robdobsn/Marty-Swing/Blog/images/Marty's Head Adjustments.jpg

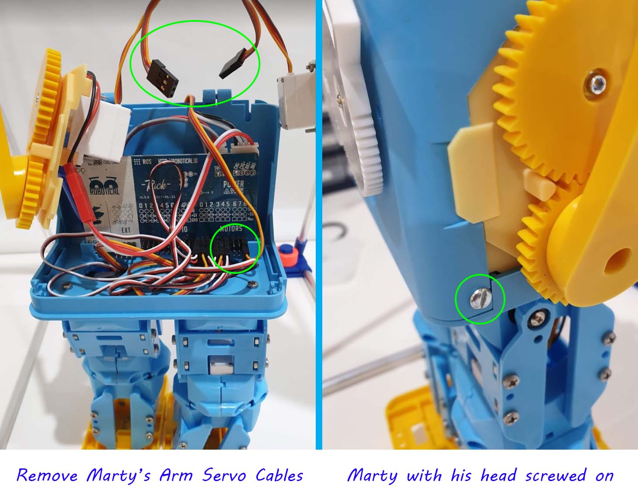
Blog/images/Marty's Head Adjustments.jpg
