robdobsn/Marty-Swing/Blog/images/Marty Attempting to Sit and Bend Knees.jpg

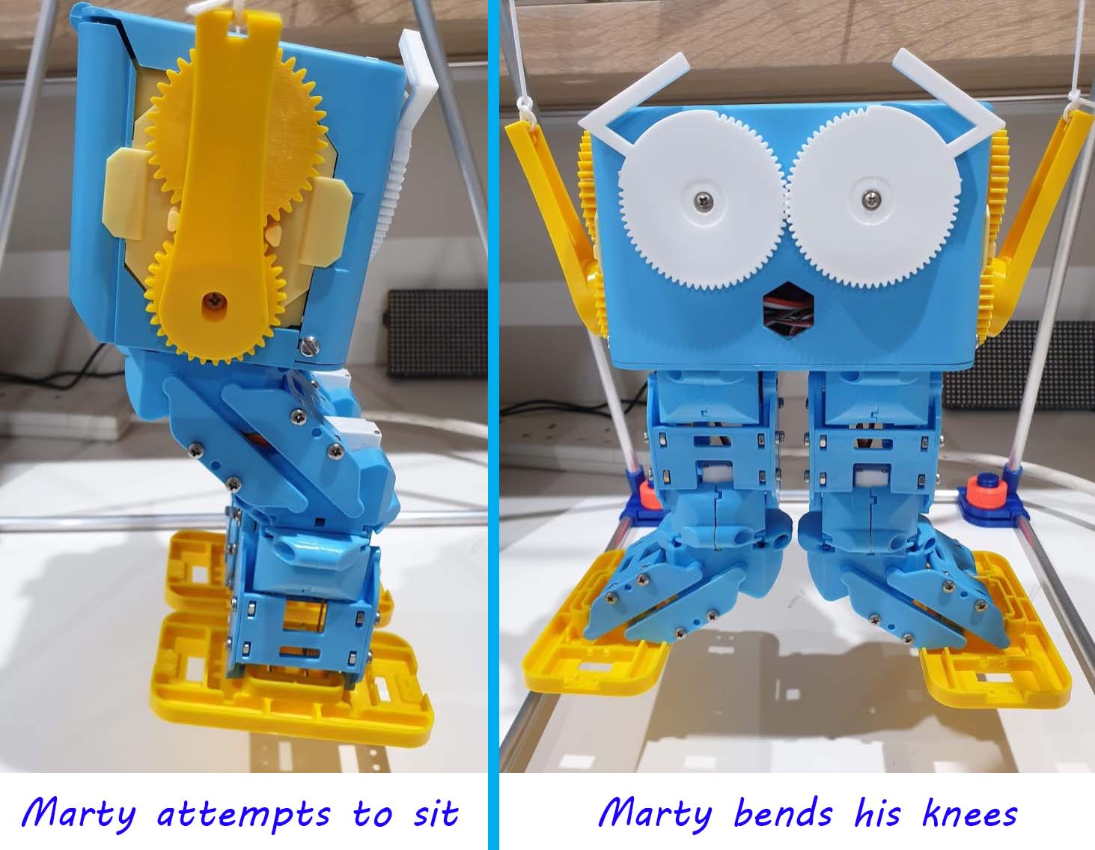
Blog/images/Marty Attempting to Sit and Bend Knees.jpg
