robdobsn/Marty-Swing/README.md

Marty Learns to Ride a Playground Swing
=======================================

Code and more to support the blog post "Marty Learns to Ride a Swing"
More information here https://robdobson.com/2019/07/marty-learns-to-ride-a-swing/
