robdobsn/Marty-Swing/Blog/images/Disconnecting Marty's Arm Servo Cables.PNG

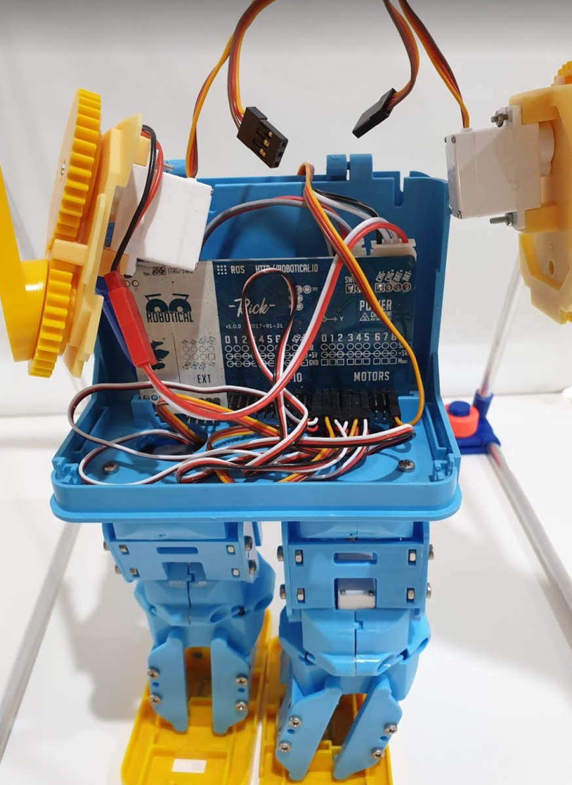
Blog/images/Disconnecting Marty's Arm Servo Cables.PNG
