robdobsn/Marty-Swing/Blog/images/FreeSwingData.png

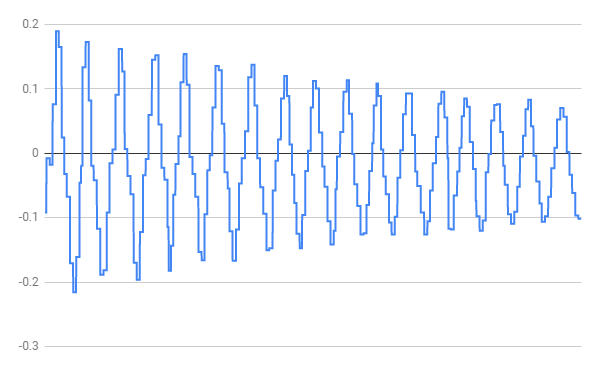
Blog/images/FreeSwingData.png
