robdobsn/Marty-Swing/Blog/images/Marty Attempting to Sit.PNG

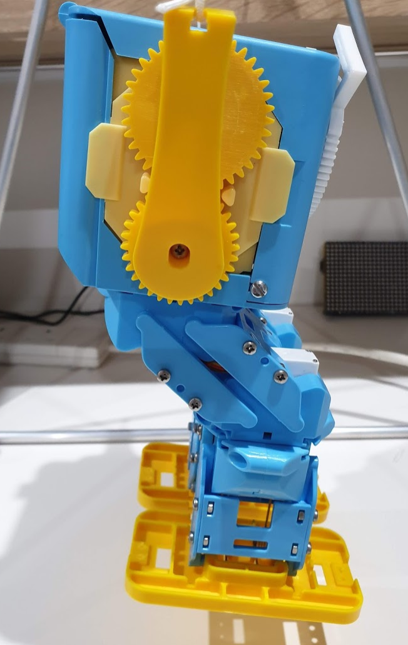
Blog/images/Marty Attempting to Sit.PNG
