robdobsn/Marty-Swing/Blog/images/Marty Bending his Knees.PNG

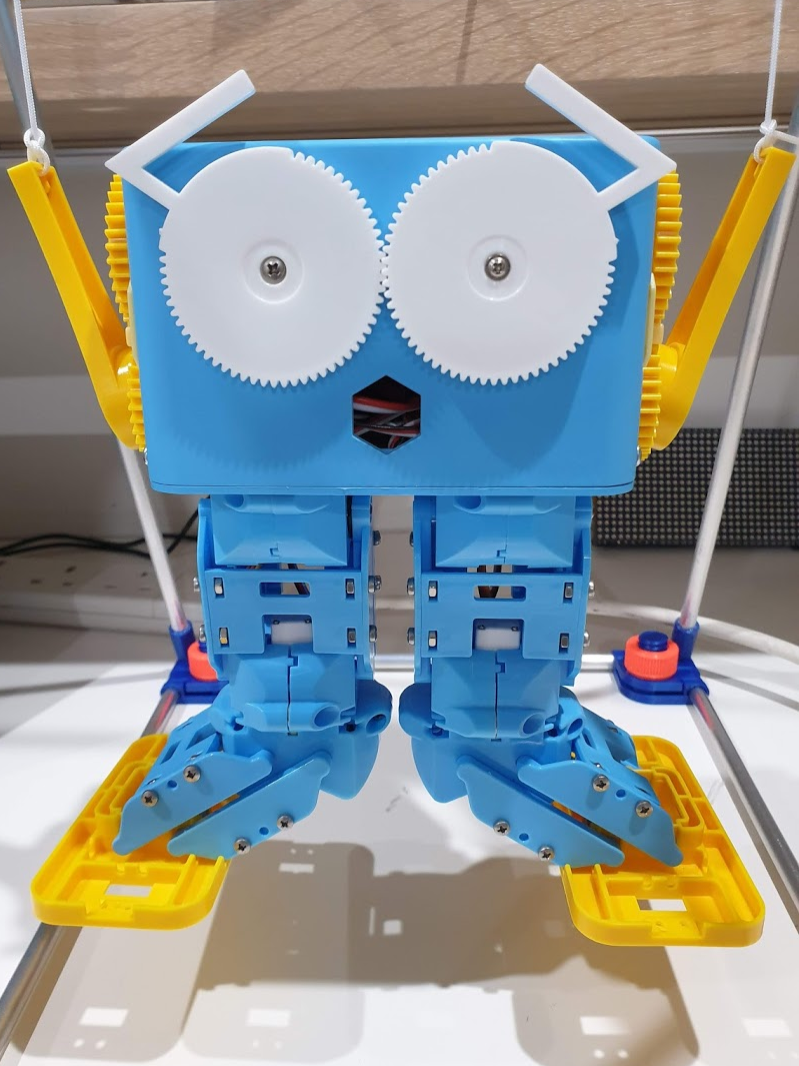
Blog/images/Marty Bending his Knees.PNG
