robdobsn/Marty-Swing/Blog/images/Marty on his Swing.jpg

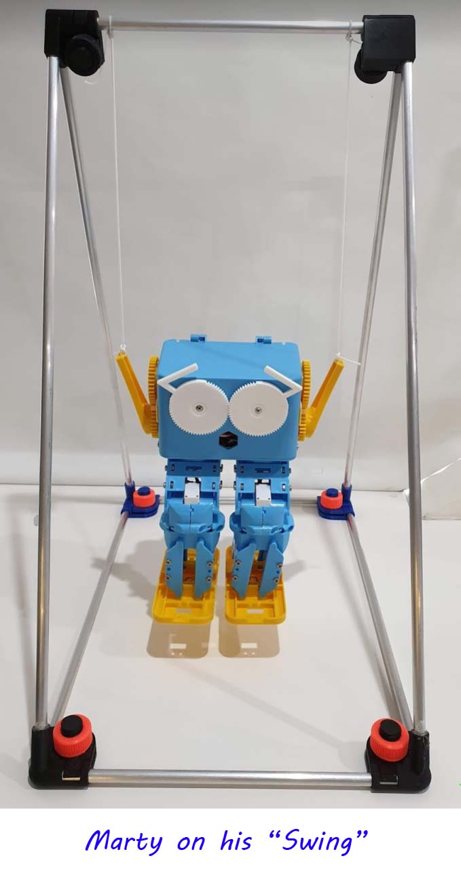
Blog/images/Marty on his Swing.jpg
