robdobsn/Marty-Swing/Blog/images/Marty on his Swing.PNG

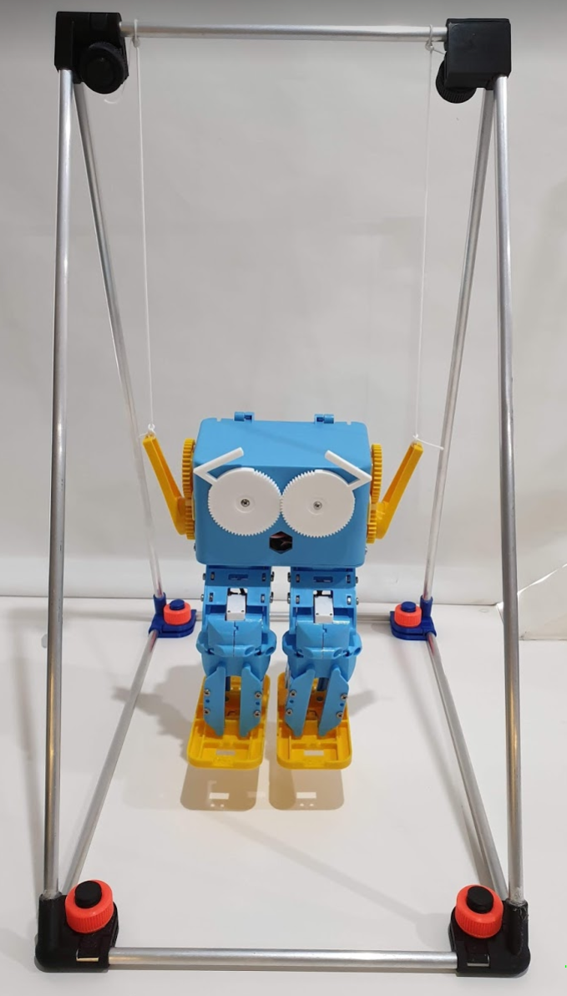
Blog/images/Marty on his Swing.PNG
