robdobsn/Marty-Swing/Blog/images/Marty Q-Learning Chart Fast Learning.jpg

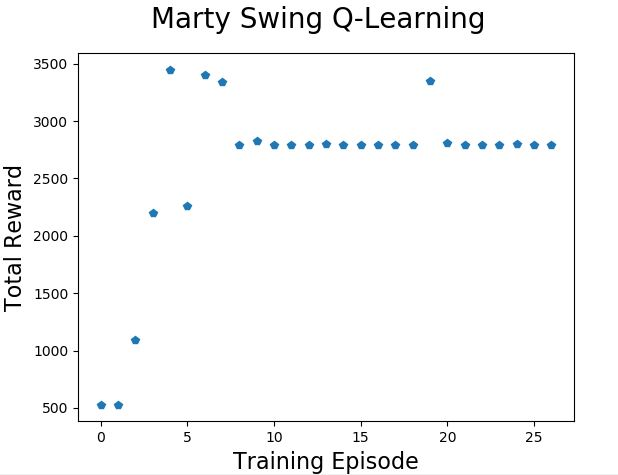
Blog/images/Marty Q-Learning Chart Fast Learning.jpg
