robdobsn/Marty-Swing/Blog/images/Marty Q-Learning Chart Medium Learning.jpg

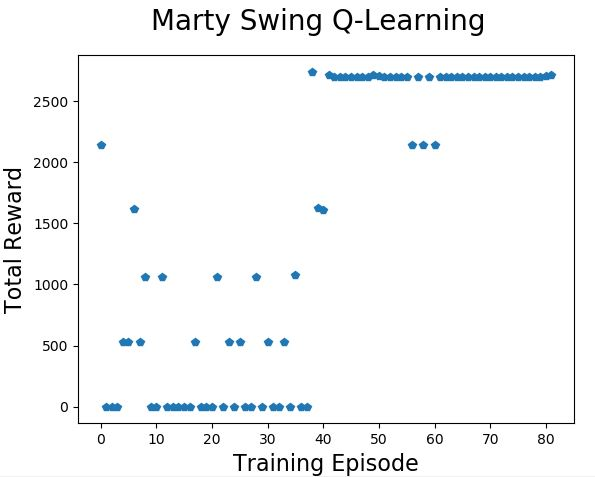
Blog/images/Marty Q-Learning Chart Medium Learning.jpg
