robdobsn/Marty-Swing/Blog/images/Marty Q-Learning Chart Slower Learning.jpg

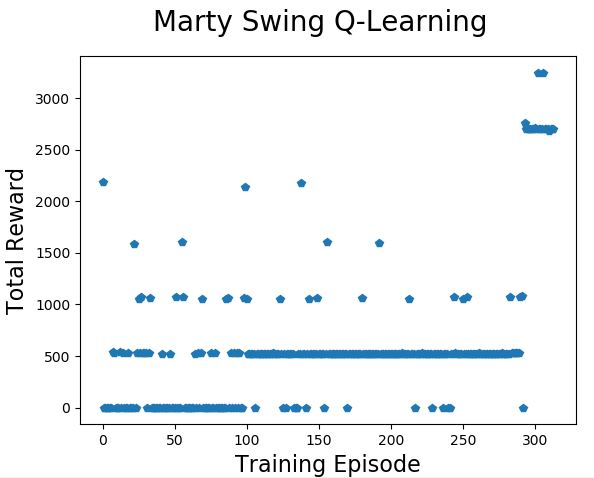
Blog/images/Marty Q-Learning Chart Slower Learning.jpg
