robdobsn/Marty-Swing/Blog/images/Marty Swing Exhaustive Best Reward.JPG

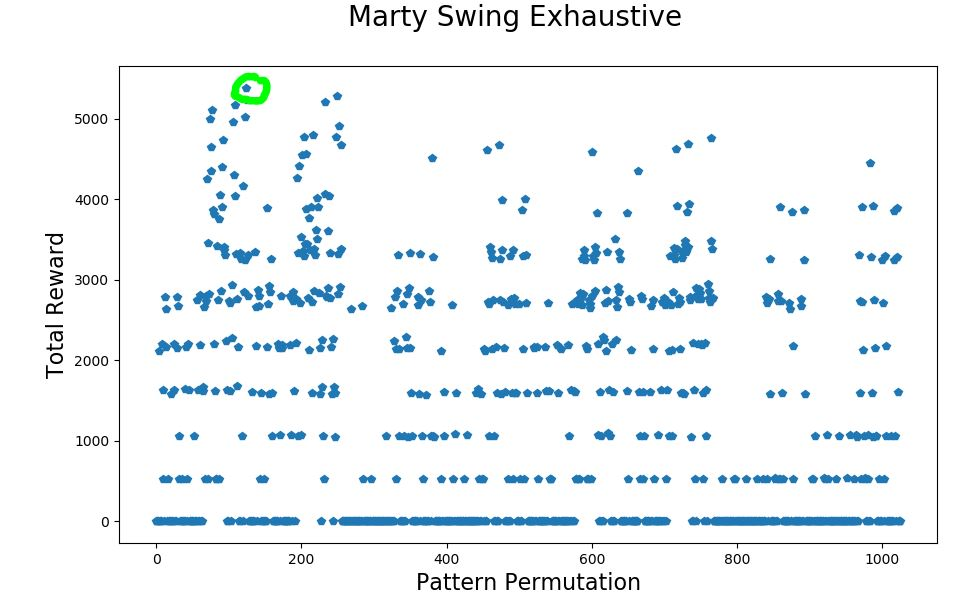
Blog/images/Marty Swing Exhaustive Best Reward.JPG
