robdobsn/Marty-Swing/Blog/images/Marty with his Head Screwed On.PNG

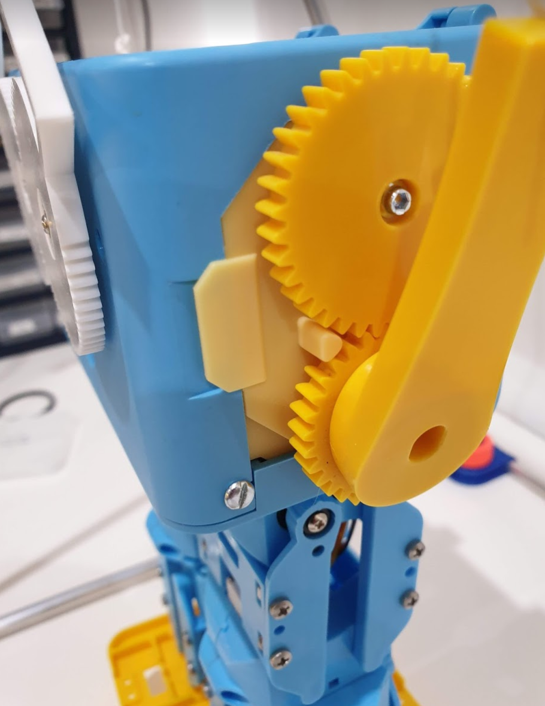
Blog/images/Marty with his Head Screwed On.PNG
