robdobsn/Marty-Swing/Blog/images/MartyLearnsToSwing.gif

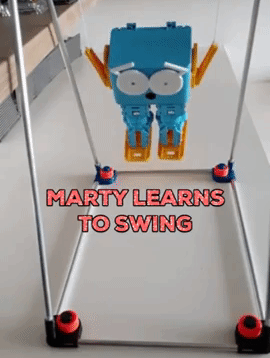
Blog/images/MartyLearnsToSwing.gif
