robdobsn/Marty-Swing/Blog/images/MartyLearnsToSwingFull.gif

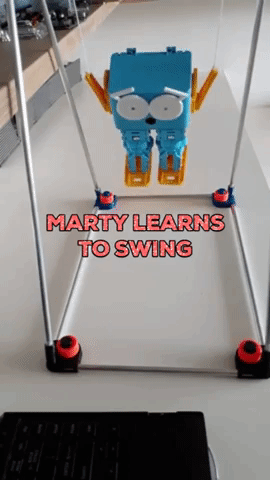
Blog/images/MartyLearnsToSwingFull.gif
