robdobsn/Marty-Swing/Blog/images/MartySwingCornerRendered.jpg

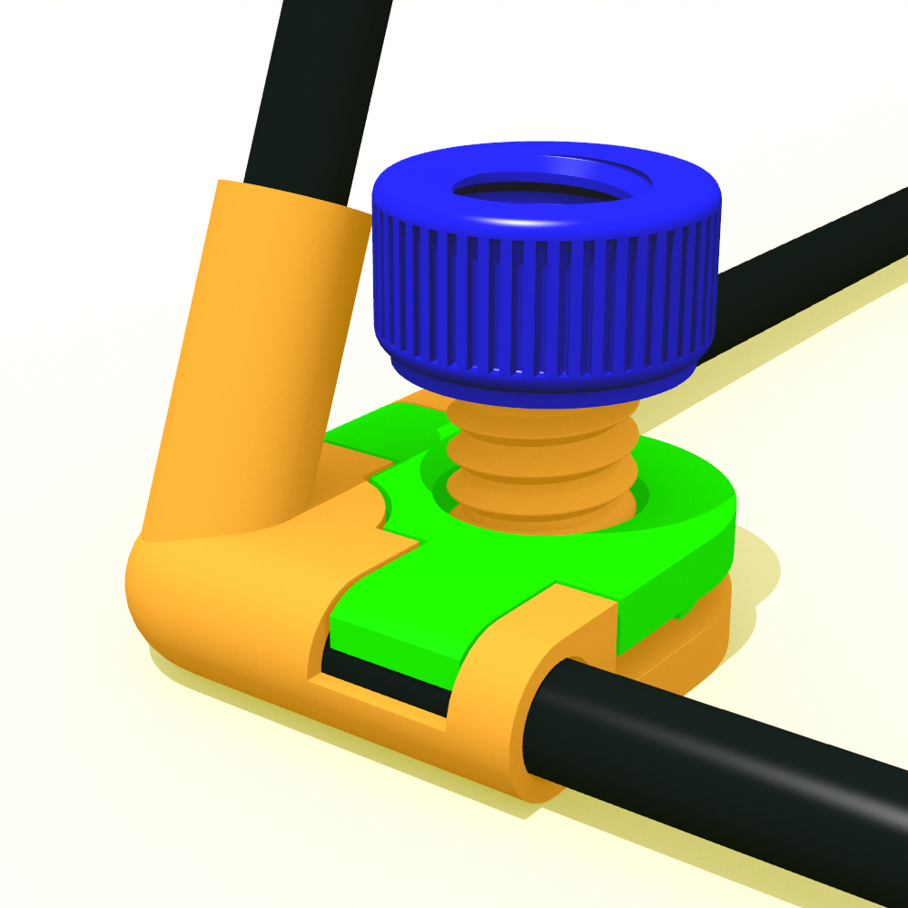
Blog/images/MartySwingCornerRendered.jpg
