robdobsn/Marty-Swing/Blog/images/MartySwingEnergy.gif

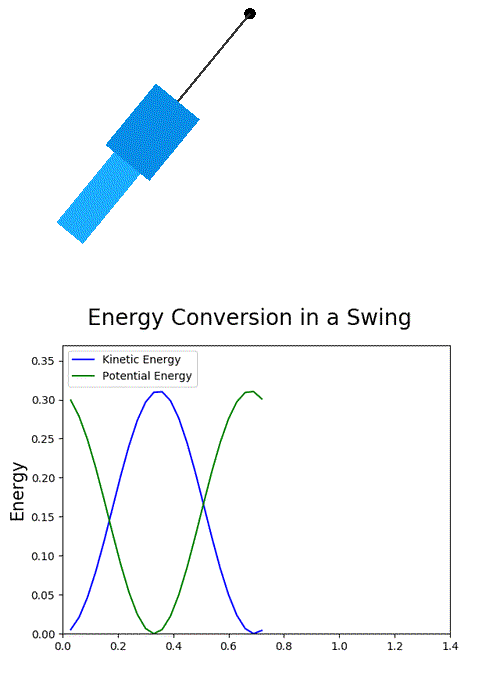
Blog/images/MartySwingEnergy.gif
