robdobsn/Marty-Swing/Blog/images/MartySwingRendered.png

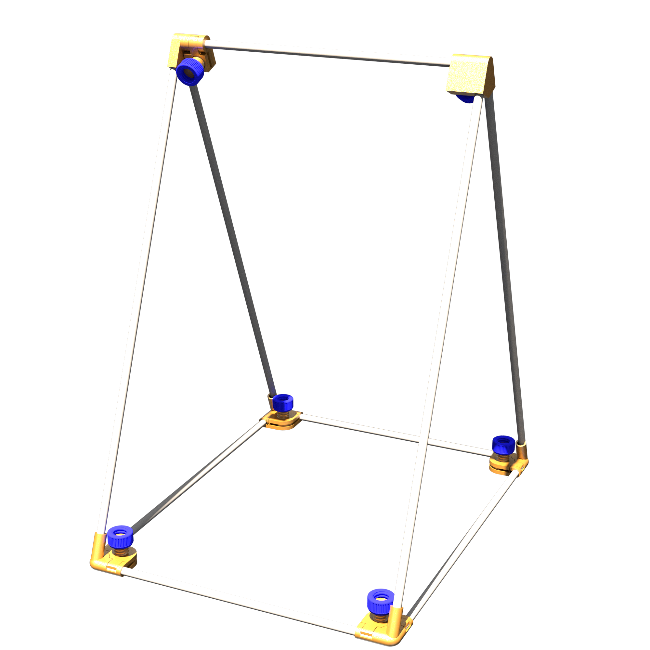
Blog/images/MartySwingRendered.png
