robdobsn/Marty-Swing/Blog/images/MartySwingTopJointRendered.jpg

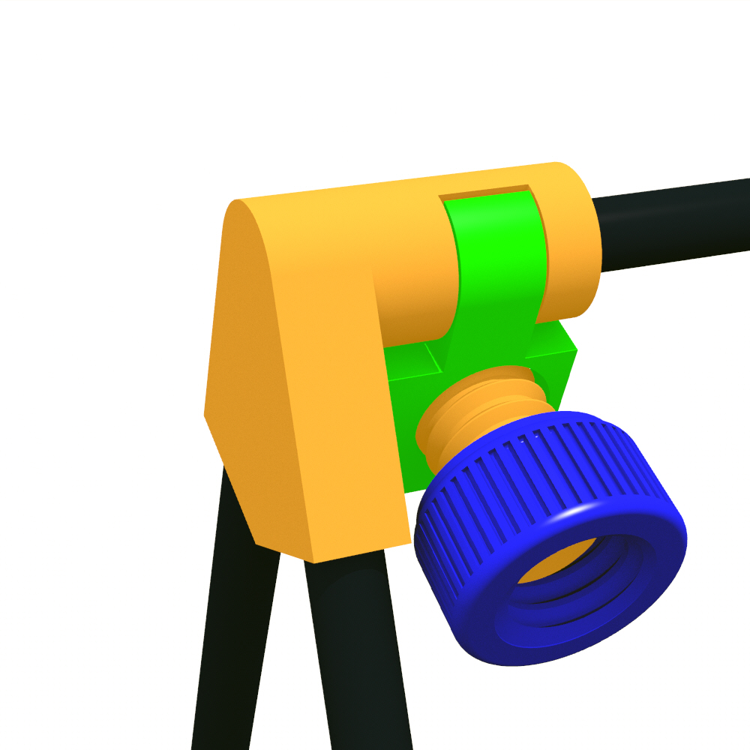
Blog/images/MartySwingTopJointRendered.jpg
