robdobsn/Marty-Swing/Blog/images/Scan for Marty the Robot.jpg

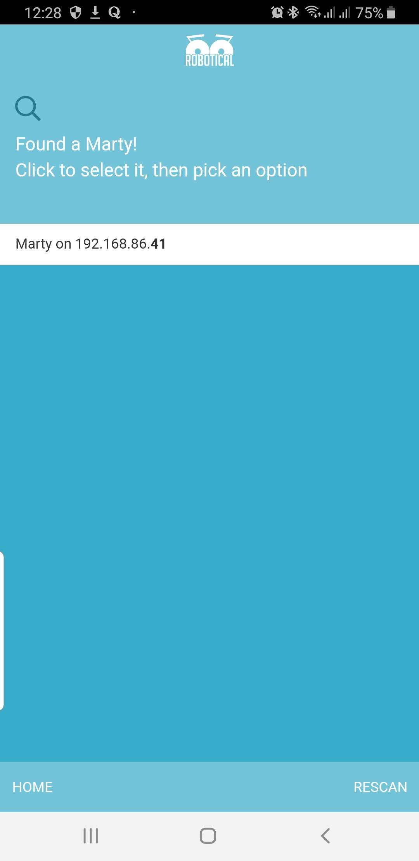
Blog/images/Scan for Marty the Robot.jpg
