robdobsn/Marty-Swing/Software/MartySwingPumpEnergy.gif

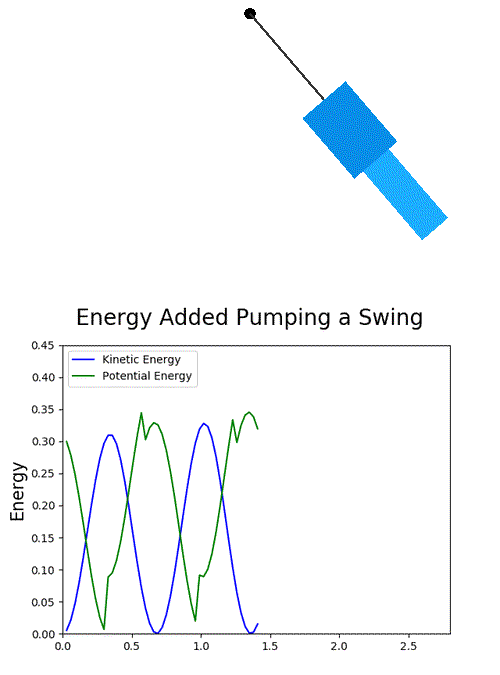
Software/MartySwingPumpEnergy.gif
