robdobsn/Marty-Swing/CAD/MartyMagneticBracket.stl

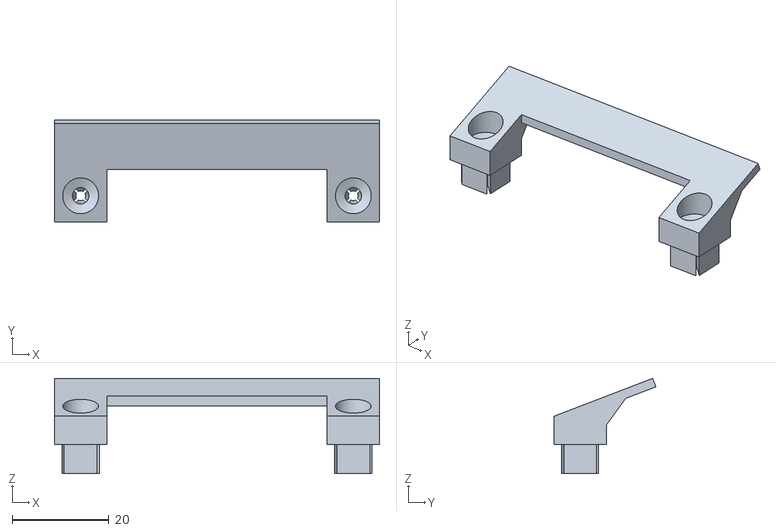
[picture p22: CAD file, 2019-07-09]
CAD/MartyMagneticBracket.stl
67.1 x 21.0 x 19.7
