robdobsn/Marty-Swing/CAD/TopJointBase.stl

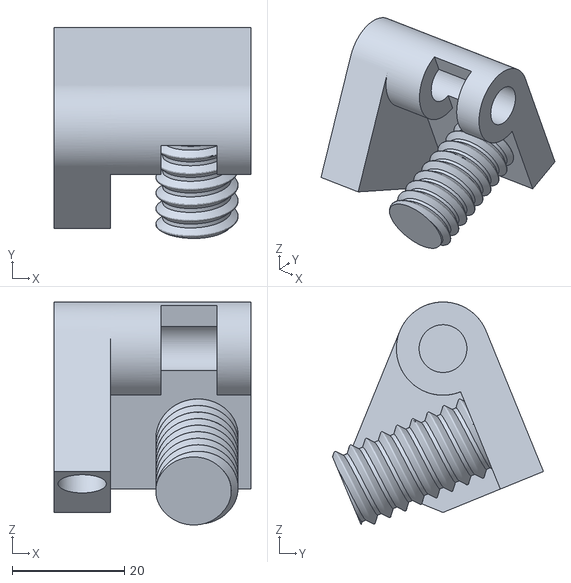
[picture p23: CAD file, 2019-07-08]
CAD/TopJointBase.stl
35.0 x 37.5 x 39.7
