robdobsn/Marty-Swing/CAD/LeftCornerBase.stl

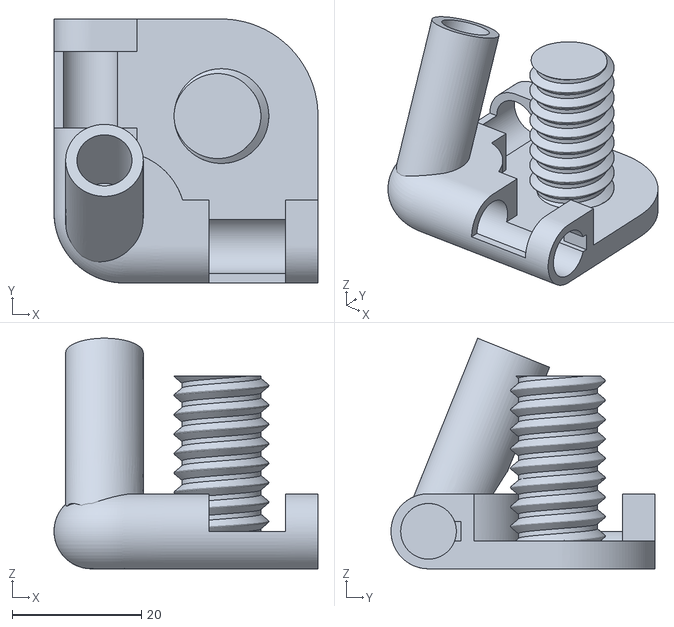
[picture p24: CAD file, 2019-07-08]
CAD/LeftCornerBase.stl
40.8 x 40.8 x 35.6
