robdobsn/Marty-Swing/CAD/TopJointPlate.stl

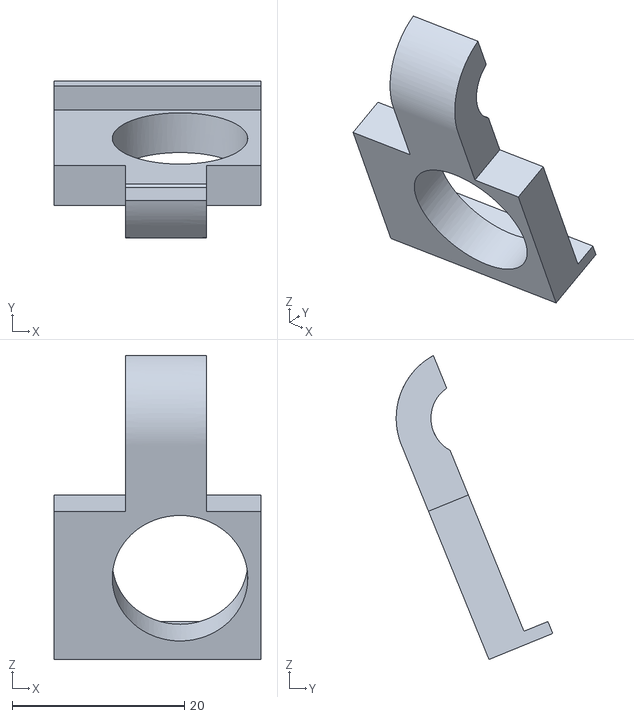
[picture p25: CAD file, 2019-07-08]
CAD/TopJointPlate.stl
24.0 x 18.2 x 35.3
