robdobsn/Marty-Swing/CAD/RightCornerTop.stl

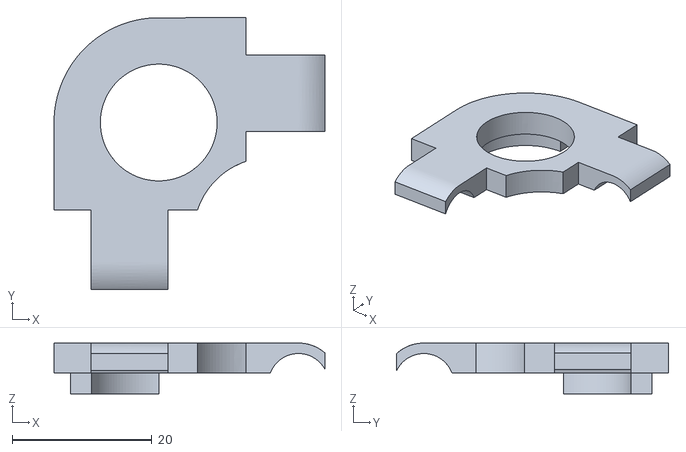
[picture p26: CAD file, 2019-07-08]
CAD/RightCornerTop.stl
38.8 x 38.9 x 7.29
