robdobsn/Marty-Swing/(list of files, cad)

Other CAD files:
CAD/LeftCornerTop.stl
CAD/RightCornerBase.stl
CAD/MartyMagneticBracket.3dm
