robdobsn/Marty-Swing/Software/Step 5 OpenAI Gym Swing/scores/scores.png

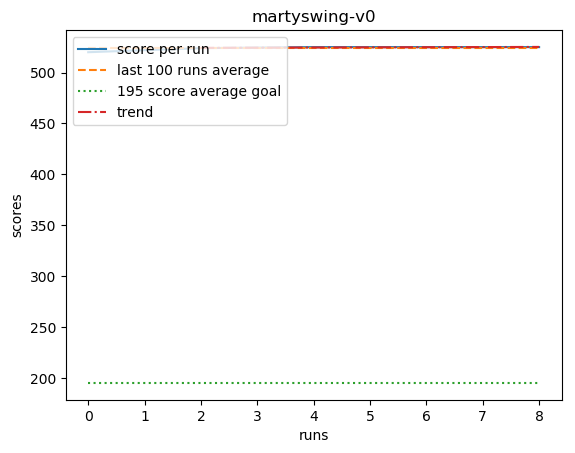
Software/Step 5 OpenAI Gym Swing/scores/scores.png
