robdobsn/Marty-Swing/Software/Step 5 OpenAI Gym Swing/scores/solved.png

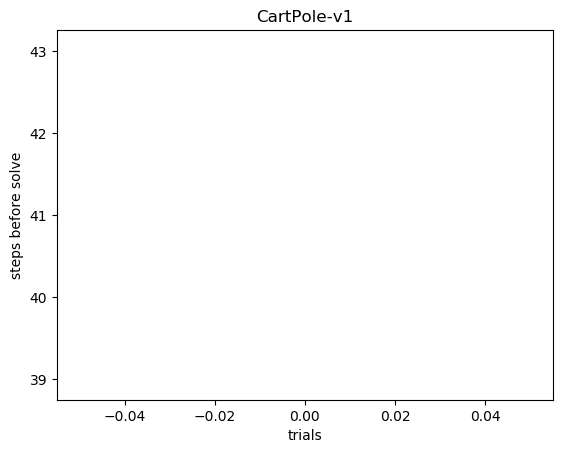
Software/Step 5 OpenAI Gym Swing/scores/solved.png
