robdobsn/Marty-Swing/Software/testruns/martySwingAndPrediction.xlsx

t | measuredXAcc | predictedXAcc
0.085 | 0.0088 | 0.361
0.137 | 0.043 | 0.3014
0.242 | 0.1348 | 0.1196
0.346 | 0.1484 | -0.0954
0.45 | 0.0801 | -0.2828
0.553 | 0.0234 | 0.1283
0.657 | 0 | -0.0158
0.761 | -0.0586 | -0.1553
1.019 | -0.1045 | -0.2544
1.072 | -0.0703 | -0.2167
1.177 | -0.0137 | -0.0969
1.28 | 0.04 | 0.0486
1.383 | 0.0928 | 0.1803
1.487 | 0.127 | 0.2612
1.593 | 0.125 | 0.2659
1.7 | 0.0352 | 0.135
1.799 | -0.0117 | 0.0434
1.903 | -0.0342 | -0.0643
2.006 | -0.0742 | -0.1524
2.113 | -0.1182 | -0.1975
2.215 | -0.0889 | -0.184
2.319 | -0.0098 | -0.1173
2.422 | 0.0312 | -0.0173
2.541 | 0.0674 | 0.1027
2.631 | 0.1191 | 0.1702
2.734 | 0.1279 | 0.2016
2.838 | 0.0684 | 0.1757
2.941 | 0.0225 | 0.0814
3.046 | -0.0137 | -0.005
3.149 | -0.0664 | -0.0881
3.255 | -0.1094 | -0.1468
3.359 | -0.0898 | -0.1612
3.462 | -0.0293 | -0.1291
3.569 | 0.0059 | -0.0567
3.669 | 0.0518 | 0.0276
3.986 | 0.1055 | 0.1601
4.096 | 0.0332 | 0.1126
4.2 | -0.0156 | 0.0311
4.299 | -0.0557 | -0.0375
4.402 | -0.0928 | -0.0978
4.504 | -0.0957 | -0.1299
4.608 | -0.0605 | -0.125
4.709 | 0.0107 | -0.0853
4.812 | 0.04 | -0.0205
4.915 | 0.0752 | 0.0504
5.019 | 0.1074 | 0.1077
5.245 | 0.0996 | 0.1164
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
