robdobsn/Marty-Swing/Blog/images/MartyMeasuredAndPredicted.PNG

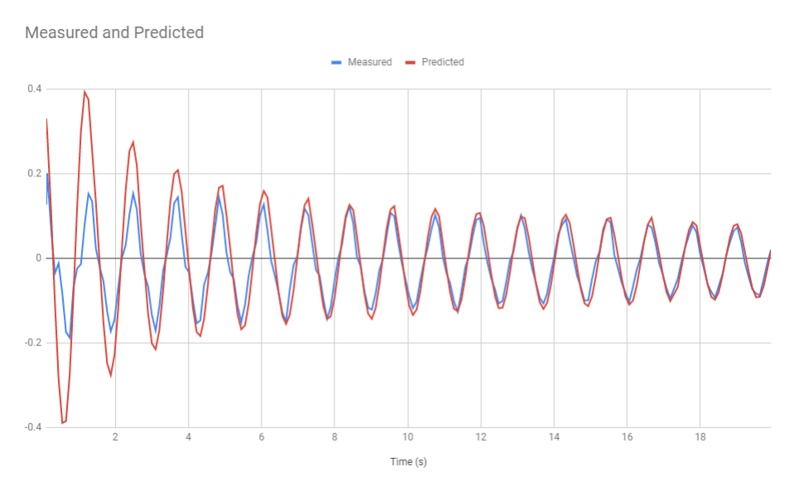
Blog/images/MartyMeasuredAndPredicted.PNG
