robdobsn/Marty-Swing/(commit log)

2019-07-08 Added TrackSwingPeriod and animation of sine curve from a wheel motion
2019-07-09 Work on a bracket for pushing or pulling Marty
    [MartyMagneticBracket.3dm, MartyMagneticBracket.stl]
2019-07-09 Implemented tracking code to lock and predict future swings
    [MartyMagneticBracket.3dm, MartyMagneticBracket.stl]
2019-07-10 Improved CAD drawing
2019-07-31 Added AI Gym and test code
    Cleaned up other examples and moved data files out of the root
    [martySwingAndPrediction - perturb1.xlsx, martySwingAndPrediction.xlsx]
2019-08-09 Working on AI Gym implementation
    [scores.csv, solved.csv]
